EwingKang/Flashlight-With-18650-Protection-Circuit/Printing Print SchematicV3_4b2.pdf

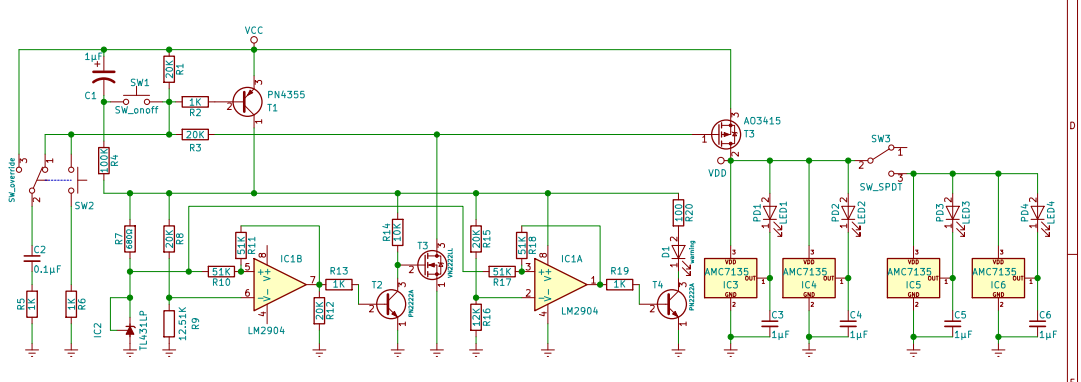
[picture p1: page 1]
