EwingKang/Flashlight-With-18650-Protection-Circuit/OldversionPDFs/Printing Print Schematic.pdf

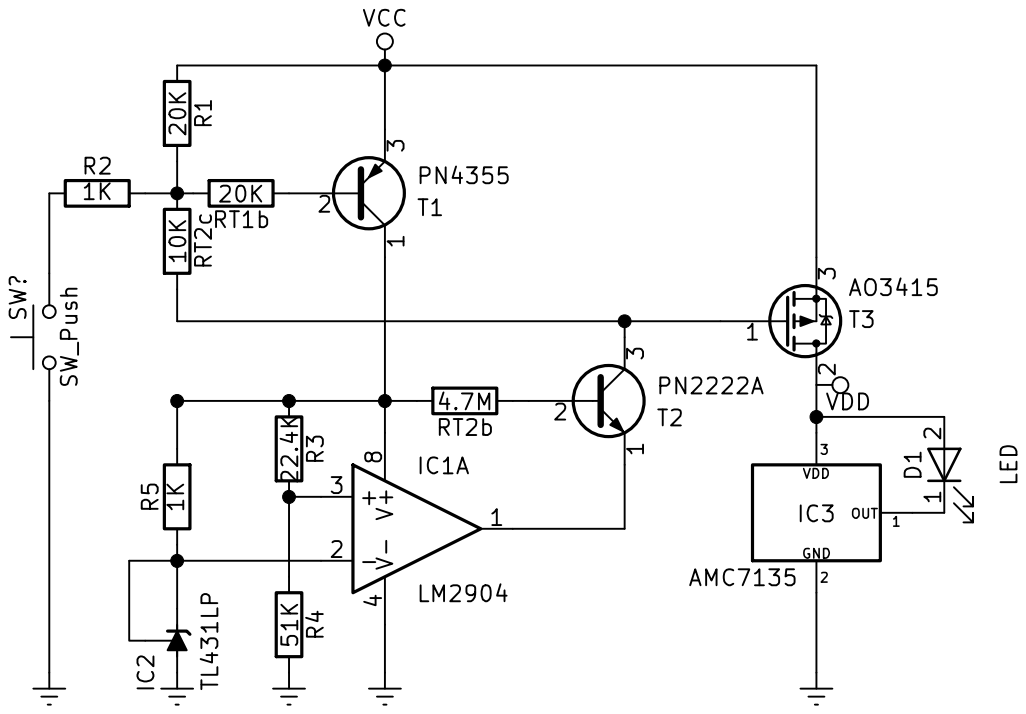
[picture p2: page 1]
