EwingKang/Flashlight-With-18650-Protection-Circuit/OldversionPDFs/Printing Print SchematicV3_1.pdf

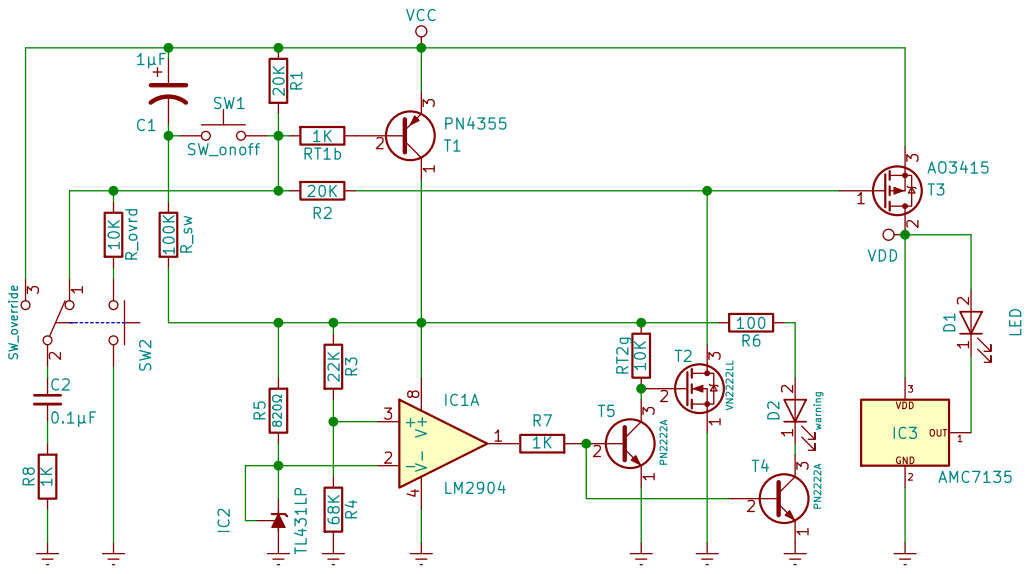
[picture p3: page 1]
