EwingKang/Flashlight-With-18650-Protection-Circuit/OldversionPDFs/Printing Print SchematicV3_1b.pdf

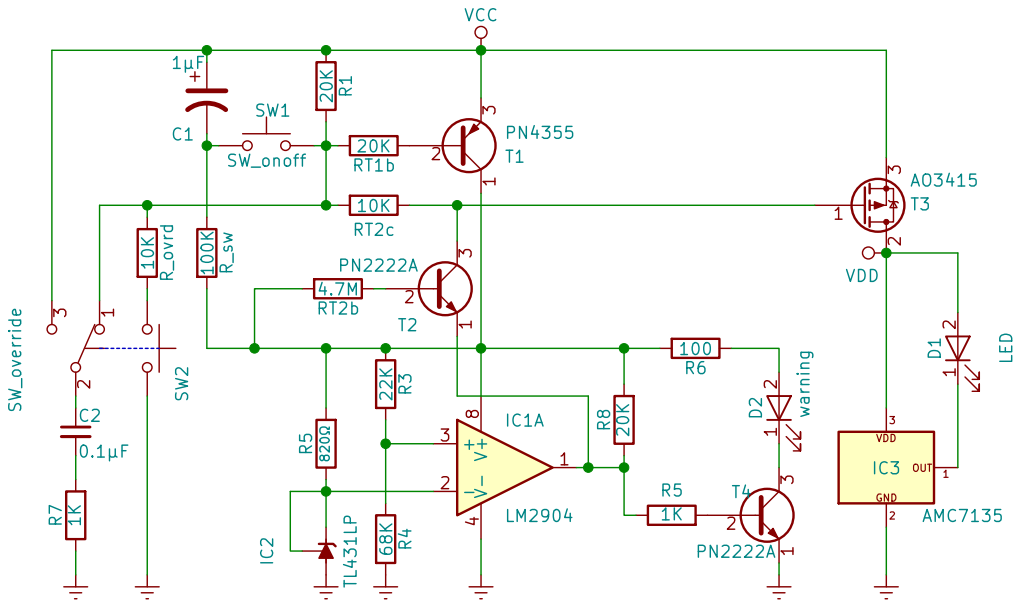
[picture p4: page 1]
