EwingKang/Flashlight-With-18650-Protection-Circuit/OldversionPDFs/Printing Print SchematicV3_1b2.pdf

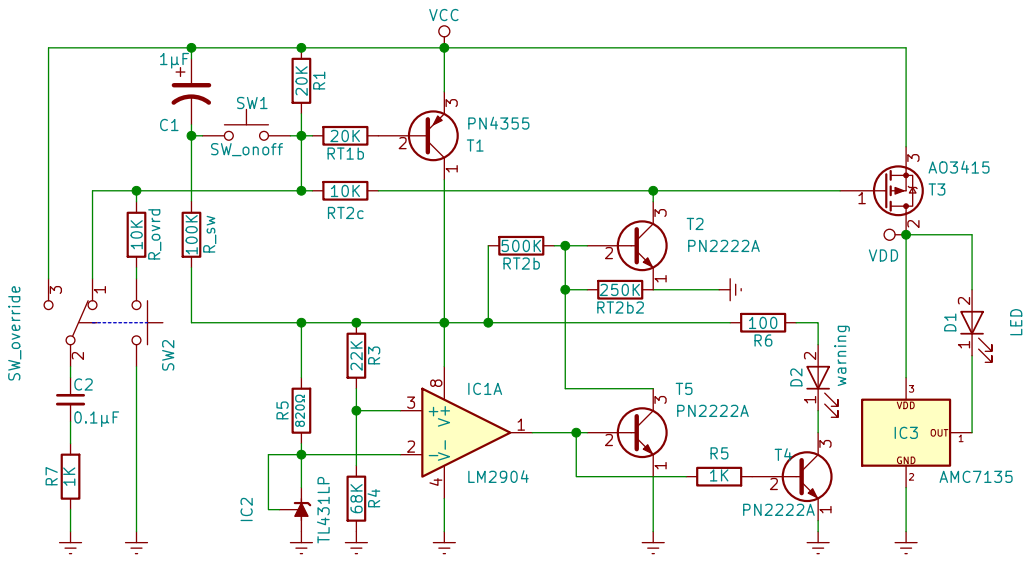
[picture p5: page 1]
