EwingKang/Flashlight-With-18650-Protection-Circuit/OldversionPDFs/Printing Print SchematicV3_2b.pdf

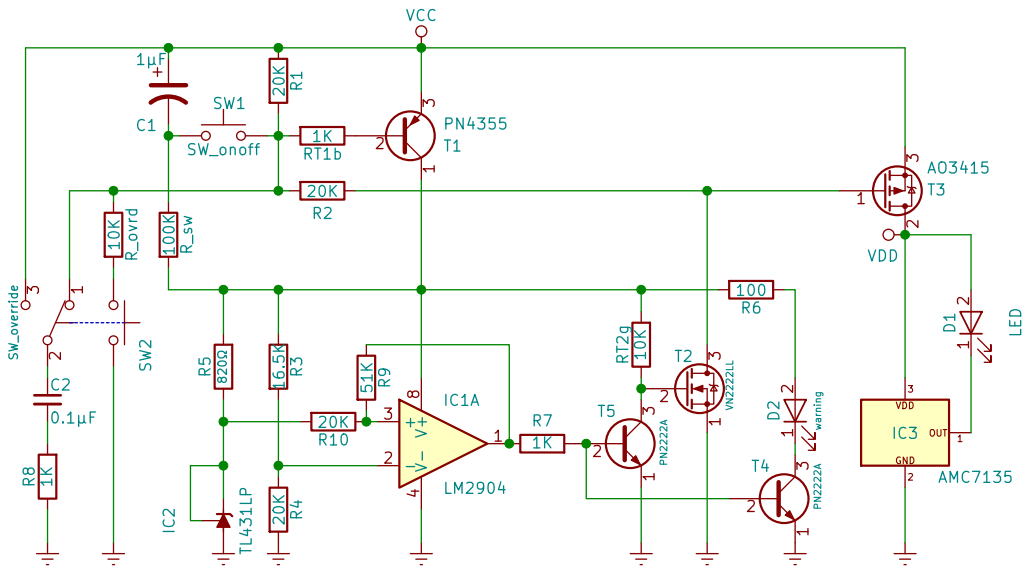
[picture p6: page 1]
