EwingKang/Flashlight-With-18650-Protection-Circuit/OldversionPDFs/Printing Print SchematicV3_3b.pdf

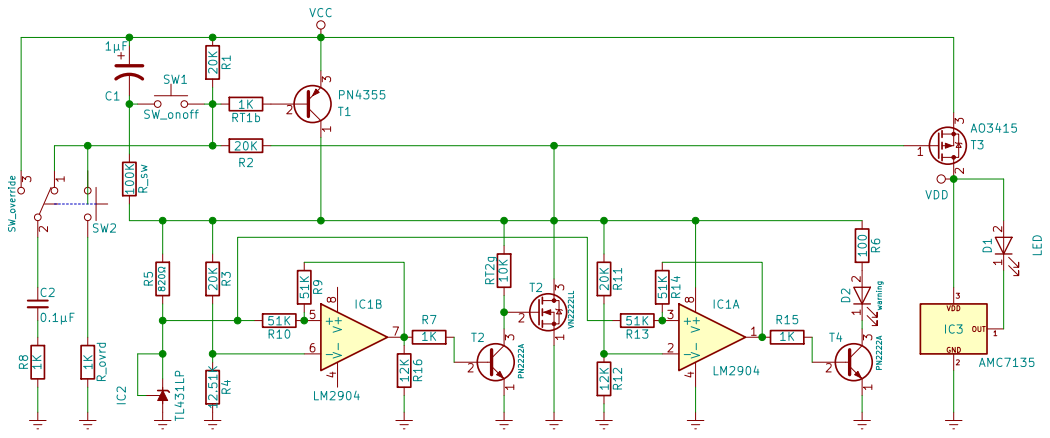
[picture p7: page 1]
