EwingKang/Flashlight-With-18650-Protection-Circuit/Kicad/Li-LED-V3.0.sch

## KiCad design Kicad/Li-LED-V3.0.sch (2017-12-18)

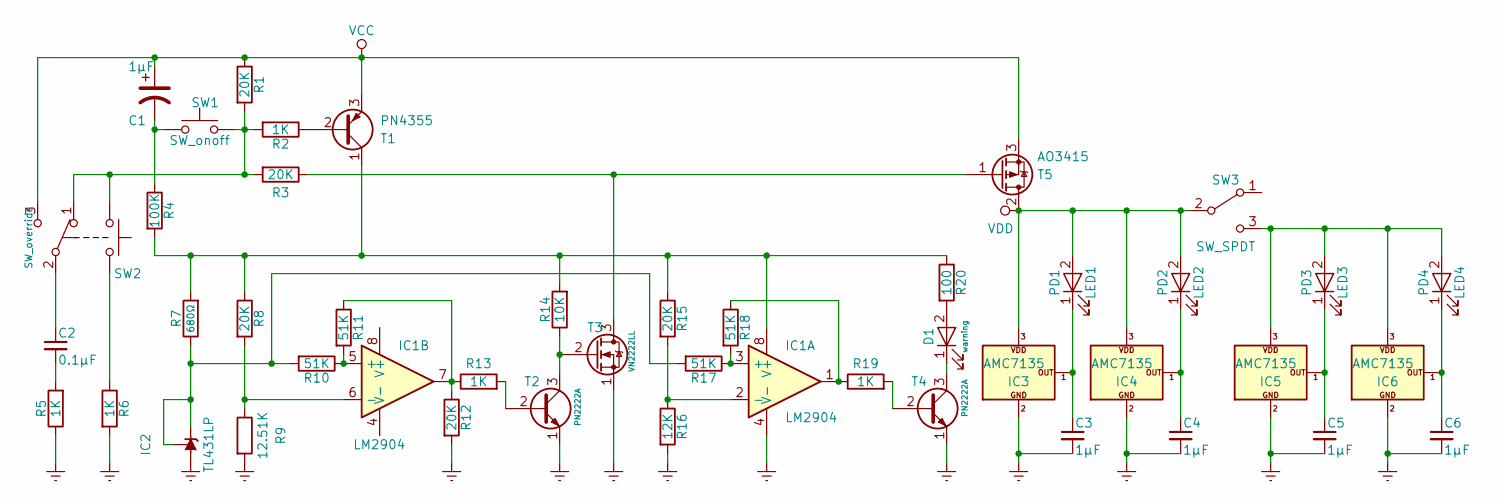
[picture p10: schematic Li-LED-V3.0.sch]

Parts:
C1, C3, C4, C5, C6: 1μF
C2: 0.1μF
D1: warning
IC1: LM2904
IC2: TL431LP; TO-92_Inline_Narrow_Oval
IC3, IC4, IC5, IC6: AMC7135; SOT89-3_Housing
PD1: LED1
PD2: LED2
PD3: LED3
PD4: LED4
R1, R3, R8, R12, R15: 20K
R2: 1K; 10K
R4: 100K
R5, R6, R13, R19: 1K
R7: 680Ω
R9: 12.51K
R10, R11, R17, R18: 51K
R14: 10K
R16: 12K
R20: 100
SW1: SW_onoff
SW2, SW2a1: SW_override
SW3: SW_SPDT
T1: PN4355
T2, T4: PN2222A; TO-92_Molded_Narrow
T3: VN2222LL; TO-92_Molded_Narrow
T5: AO3415

Connections:
Earth: C3.2, C4.2, C5.2, C6.2, IC1.4 (V-), IC2.2 (A), IC3.2 (GND), IC4.2 (GND), IC5.2 (GND), IC6.2 (GND), R5.1, R6.2, R9.2, R12.2, R16.2, T2.1 (E), T3.1 (S), T4.1 (E)
unnamed: C1.2, R4.1, SW1.1
unnamed: C2.1, SW2.2 (B)
unnamed: C2.2, R5.2
unnamed: C3.1, IC3.1 (OUT), PD1.1 (K)
unnamed: C4.1, IC4.1 (OUT), PD2.1 (K)
unnamed: C5.1, IC5.1 (OUT), PD3.1 (K)
unnamed: C6.1, IC6.1 (OUT), PD4.1 (K)
unnamed: D1.1 (K), T4.3 (C)
unnamed: D1.2 (A), R20.2
unnamed: IC1.1, R18.1, R19.1
unnamed: IC1.2 (-), R15.2, R16.1
unnamed: IC1.3 (+), R17.1, R18.2
unnamed: IC1.5 (+), R10.1, R11.2
unnamed: IC1.6 (-), R8.2, R9.1
unnamed: IC1.7, R11.1, R12.1, R13.1
unnamed: IC1.8 (V+), R4.2, R7.2, R8.1, R14.2, R15.1, R20.1, T1.1 (C)
unnamed: IC2.1 (REF), IC2.3 (K), R7.1, R10.2, R17.2
unnamed: IC5.3 (VDD), IC6.3 (VDD), PD3.2 (A), PD4.2 (A), SW3.3 (C)
unnamed: R1.2, R2.2, R3.2, SW1.2, SW2.1 (A), SW2a1.2
unnamed: R2.1, T1.2 (B)
unnamed: R3.1, T3.3 (D), T5.1 (G)
unnamed: R6.1, SW2a1.1
unnamed: R13.2, T2.2 (B)
unnamed: R14.1, T2.3 (C), T3.2 (G)
unnamed: R19.2, T4.2 (B)
VCC: C1.1, R1.1, SW2.3 (C), T1.3 (E), T5.3 (S)
VDD: IC3.3 (VDD), IC4.3 (VDD), PD1.2 (A), PD2.2 (A), SW3.2 (B), T5.2 (D)
